ghostintranslation/cycle/(commit log)

2020-06-27 Updated schematics
2020-07-05 Fixed Play/Stop clock switch not workin anymore
    Fixed Play/Stop clock switch not workin anymore
    [Sequencer.h]
2020-07-06 Report Motherboard12 encoder changes
    Reported Motherboard12 encoder changes
2020-08-12 Replaced Accent by Octave
    [Cycle.h, Display.h]
2020-08-13 Scales - Completed scales - Fixed issue with notes playing when stopping the sequencer - Fixed the sequencer is not playing when in Octave screen
    [Cycle.h, Display.h]
2020-08-18 Fixed Midi note off messages not sent
    [Cycle.h]
